CatastrophicCo/OpenScale/cad/push-button-64.snapshot.5/push button/push button render.PNG

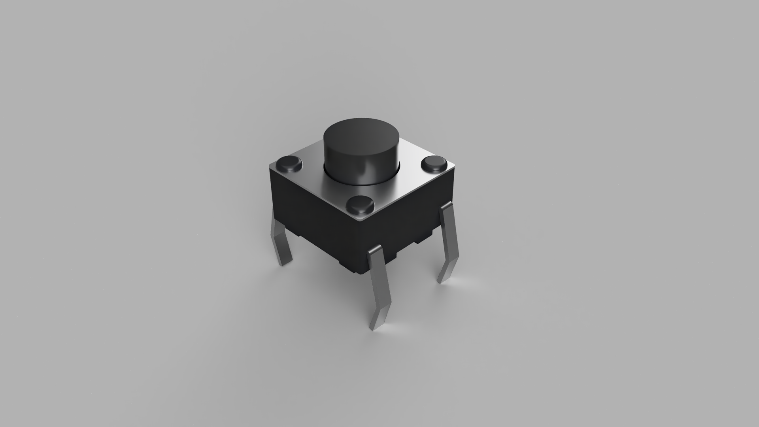
cad/push-button-64.snapshot.5/push button/push button render.PNG
