CatastrophicCo/OpenScale/cad/display-oled128x32-1.snapshot.4/128x32-OLED.STEP

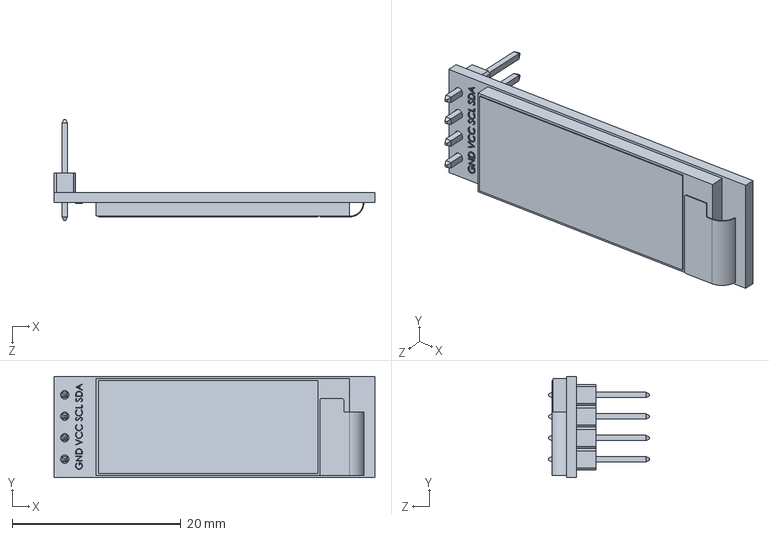
[picture p2: CAD file, 2026-01-29]
cad/display-oled128x32-1.snapshot.4/128x32-OLED.STEP
38.0 x 12.0 x 11.9 mm
