CatastrophicCo/OpenScale/cad/push-button-64.snapshot.5/push button/push button.step

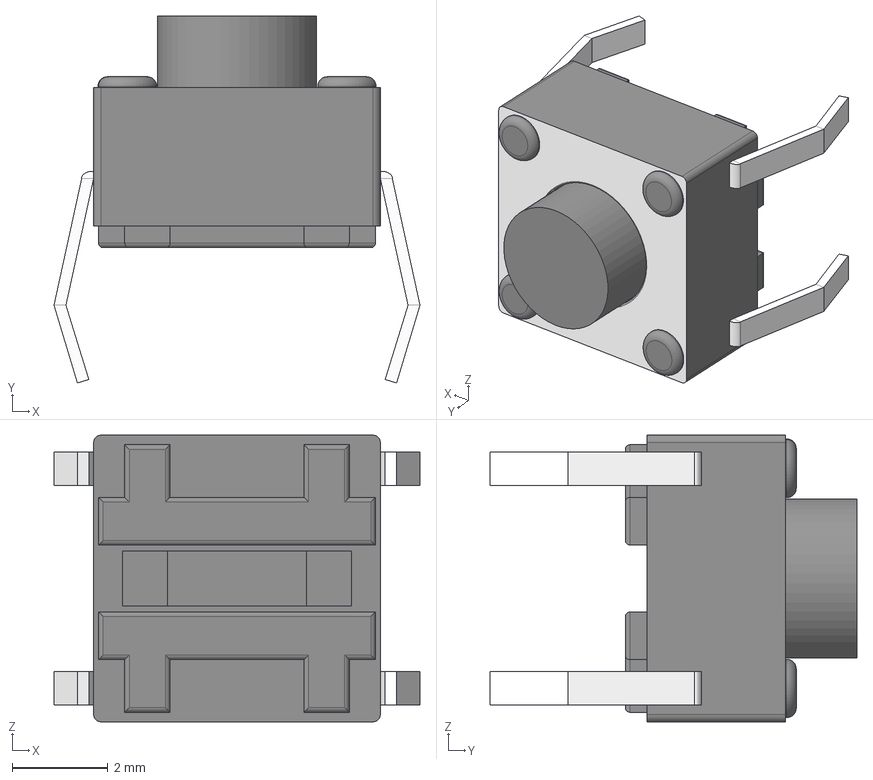
[picture p3: CAD file, 2026-01-29]
cad/push-button-64.snapshot.5/push button/push button.step
7.66 x 7.68 x 6.00 mm
