CatastrophicCo/OpenScale/(list of files, cad)

Other CAD files:
cad/display-oled128x32-1.snapshot.4/128x32-OLED.SLDPRT
