CatastrophicCo/OpenScale/hardware/kicad/OpenScale.kicad_sch

## KiCad design hardware/kicad/OpenScale.kicad_sch (2026-01-31)

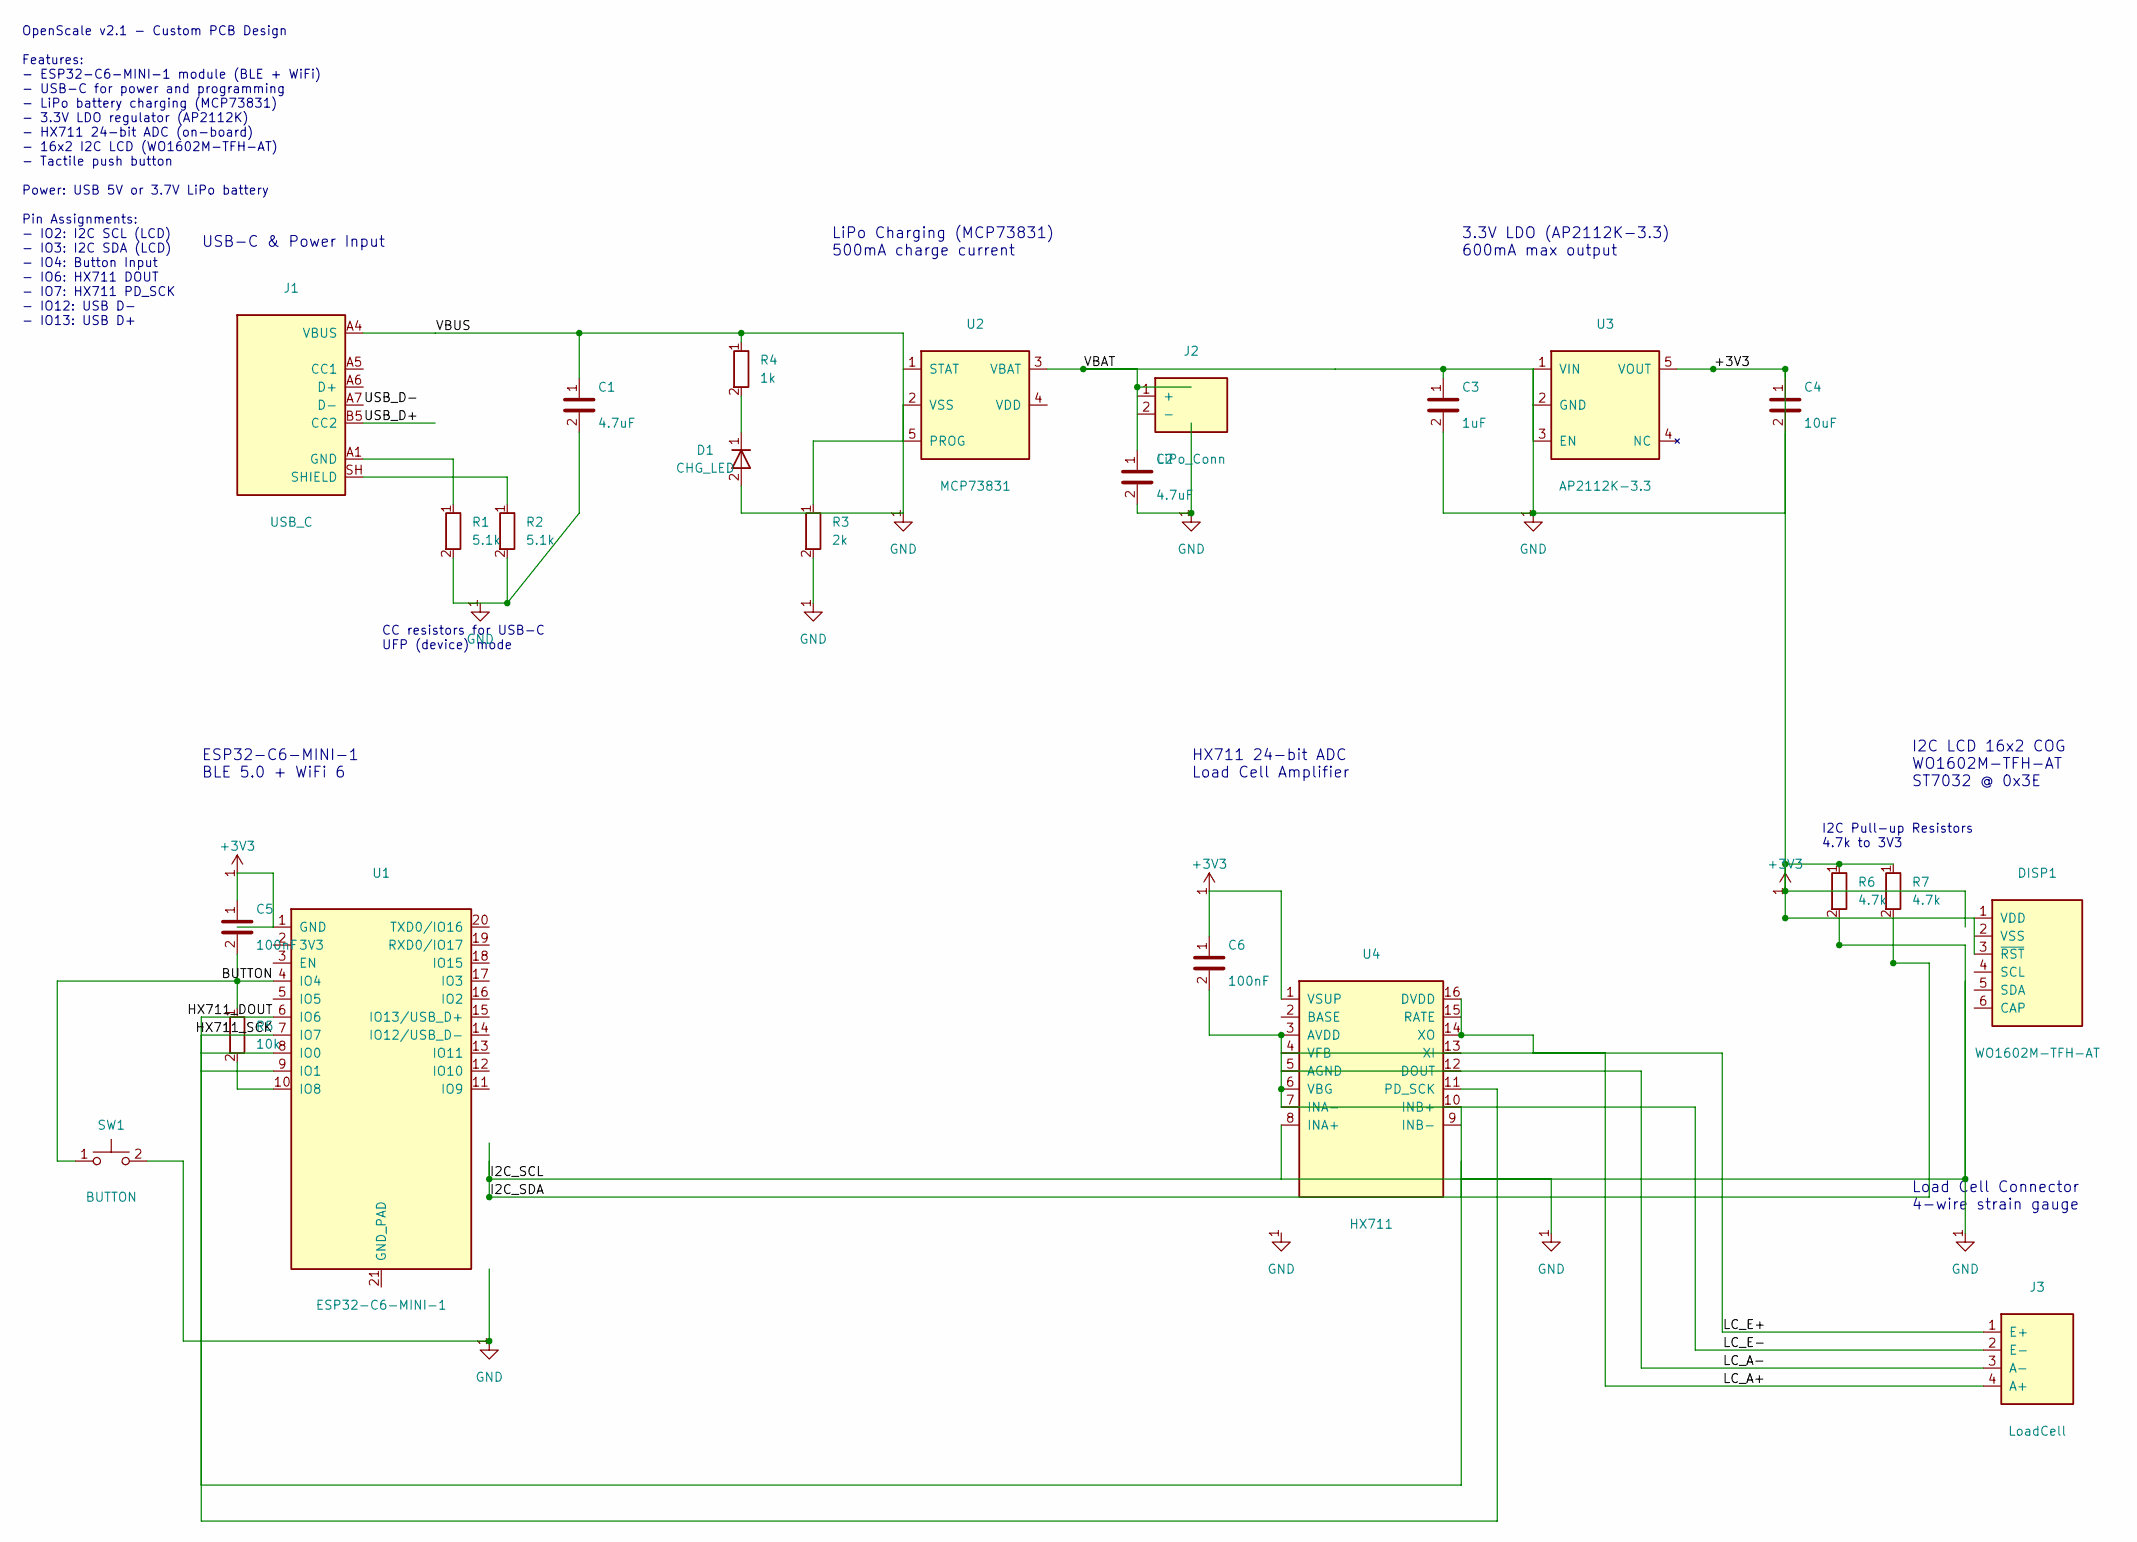
[picture p5: schematic OpenScale.kicad_sch]

Parts:
C1, C2: 4.7uF; C_0805_2012Metric
C3: 1uF; C_0805_2012Metric
C4: 10uF; C_0805_2012Metric
C5, C6: 100nF; C_0805_2012Metric
D1: CHG_LED; LED_0805_2012Metric
DISP1: WO1602M-TFH-AT; MPN WO1602M-TFH-AT
J1: USB_C; USB_C_Receptacle_GCT_USB4085
J2: LiPo_Conn; JST_PH_B2B-PH-K_1x02_P2.00mm_Vertical
J3: LoadCell; JST_XH_B4B-XH-A_1x04_P2.50mm_Vertical
R1, R2: 5.1k; R_0805_2012Metric
R3: 2k; R_0805_2012Metric
R4: 1k; R_0805_2012Metric
R5: 10k; R_0805_2012Metric
R6, R7: 4.7k; R_0805_2012Metric
SW1: BUTTON; SW_SPST_TL3342
U1: ESP32-C6-MINI-1
U2: MCP73831; SOT-23-5
U3: AP2112K-3.3; SOT-23-5
U4: HX711; SOP-16_4.4x10.4mm_P1.27mm

Connections:
+3V3: C4.1, C5.1, C6.1, DISP1.1 (VDD), DISP1.3 (~RST), R6.1, R7.1, U1.1 (GND), U3.5 (VOUT), U4.1 (VSUP)
BUTTON: C5.2, R5.1, SW1.1, U1.4 (IO4)
GND: C1.1, C1.2, C2.1, C2.2, C3.1, C3.2, C4.2, D1.2 (A), J1.A4 (VBUS), R1.2, R2.2, R3.1, R3.2, R4.1, R6.2, R7.2, SW1.2, U2.1 (STAT), U2.2 (VSS), U2.3 (VBAT), U2.5 (PROG), U3.1 (VIN), U3.2 (GND), U3.3 (EN)
HX711_DOUT: U1.6 (IO6), U4.10 (INB+)
HX711_SCK: U1.7 (IO7), U4.11 (PD_SCK)
LC_A+: J3.4 (A+), U4.4 (VFB)
LC_A-: J3.3 (A-), U4.5 (AGND)
LC_E+: J3.1 (E+), U4.14 (XO), U4.16 (DVDD)
LC_E-: C6.2, J3.2 (E-), U4.3 (AVDD), U4.6 (VBG), U4.7 (INA-)
unnamed: D1.1 (K), R4.2
unnamed: J1.A1 (GND), R1.1
unnamed: J1.SH (SHIELD), R2.1
unnamed: R5.2, U1.10 (IO8)
USB_D+: J1.B5 (CC2)
USB_D-: J1.A7 (D-)

Notes on the sheet:
OpenScale v2.1 - Custom PCB Design Features: - ESP32-C6-MINI-1 module (BLE + WiFi) - USB-C for power and programming - LiPo battery charging (MCP73831) - 3.3V LDO regulator (AP2112K) - HX711 24-bit ADC (on-board) - 16x2 I2C LCD (WO1602M-TFH-AT) - Tactile push button Power: USB 5V or 3.7V LiPo batte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
USB-C & Power Input
LiPo Charging (MCP73831) 500mA charge current
3.3V LDO (AP2112K-3.3) 600mA max output
ESP32-C6-MINI-1 BLE 5.0 + WiFi 6
HX711 24-bit ADC Load Cell Amplifier
I2C LCD 16x2 COG WO1602M-TFH-AT ST7032 @ 0x3E
Load Cell Connector 4-wire strain gauge
CC resistors for USB-C UFP (device) mode
I2C Pull-up Resistors 4.7k to 3V3
