CatastrophicCo/OpenScale/(commit log)

2026-01-24 Add website updates and support device name change
2026-01-24 Add reset of the files needed from last commit
    [OpenScale.ino, config.h]
2026-01-24 Update app and set up button input
2026-01-29 Add custom weight calibration, manual factor setting, and graph time range controls to web and Flutter apps
    [128x32-OLED.SLDPRT, 128x32-OLED.STEP, Seeed Studio XIAO ESP32-C6.step, push button.step]
2026-01-31 Add KiCad PCB schematic with WO1602M LCD and app emulator mode
    [OpenScale.kicad_sch]
